Shaman7312/UV-Exposure/README.md

# UV-Exposure
Exposure unit for making PCBs
