Shaman7312/UV-Exposure/UV-Exposer_KiCad/UV-Exposer.kicad_pcb

## KiCad design UV-Exposer_KiCad/UV-Exposer.kicad_pcb (2017-09-11)

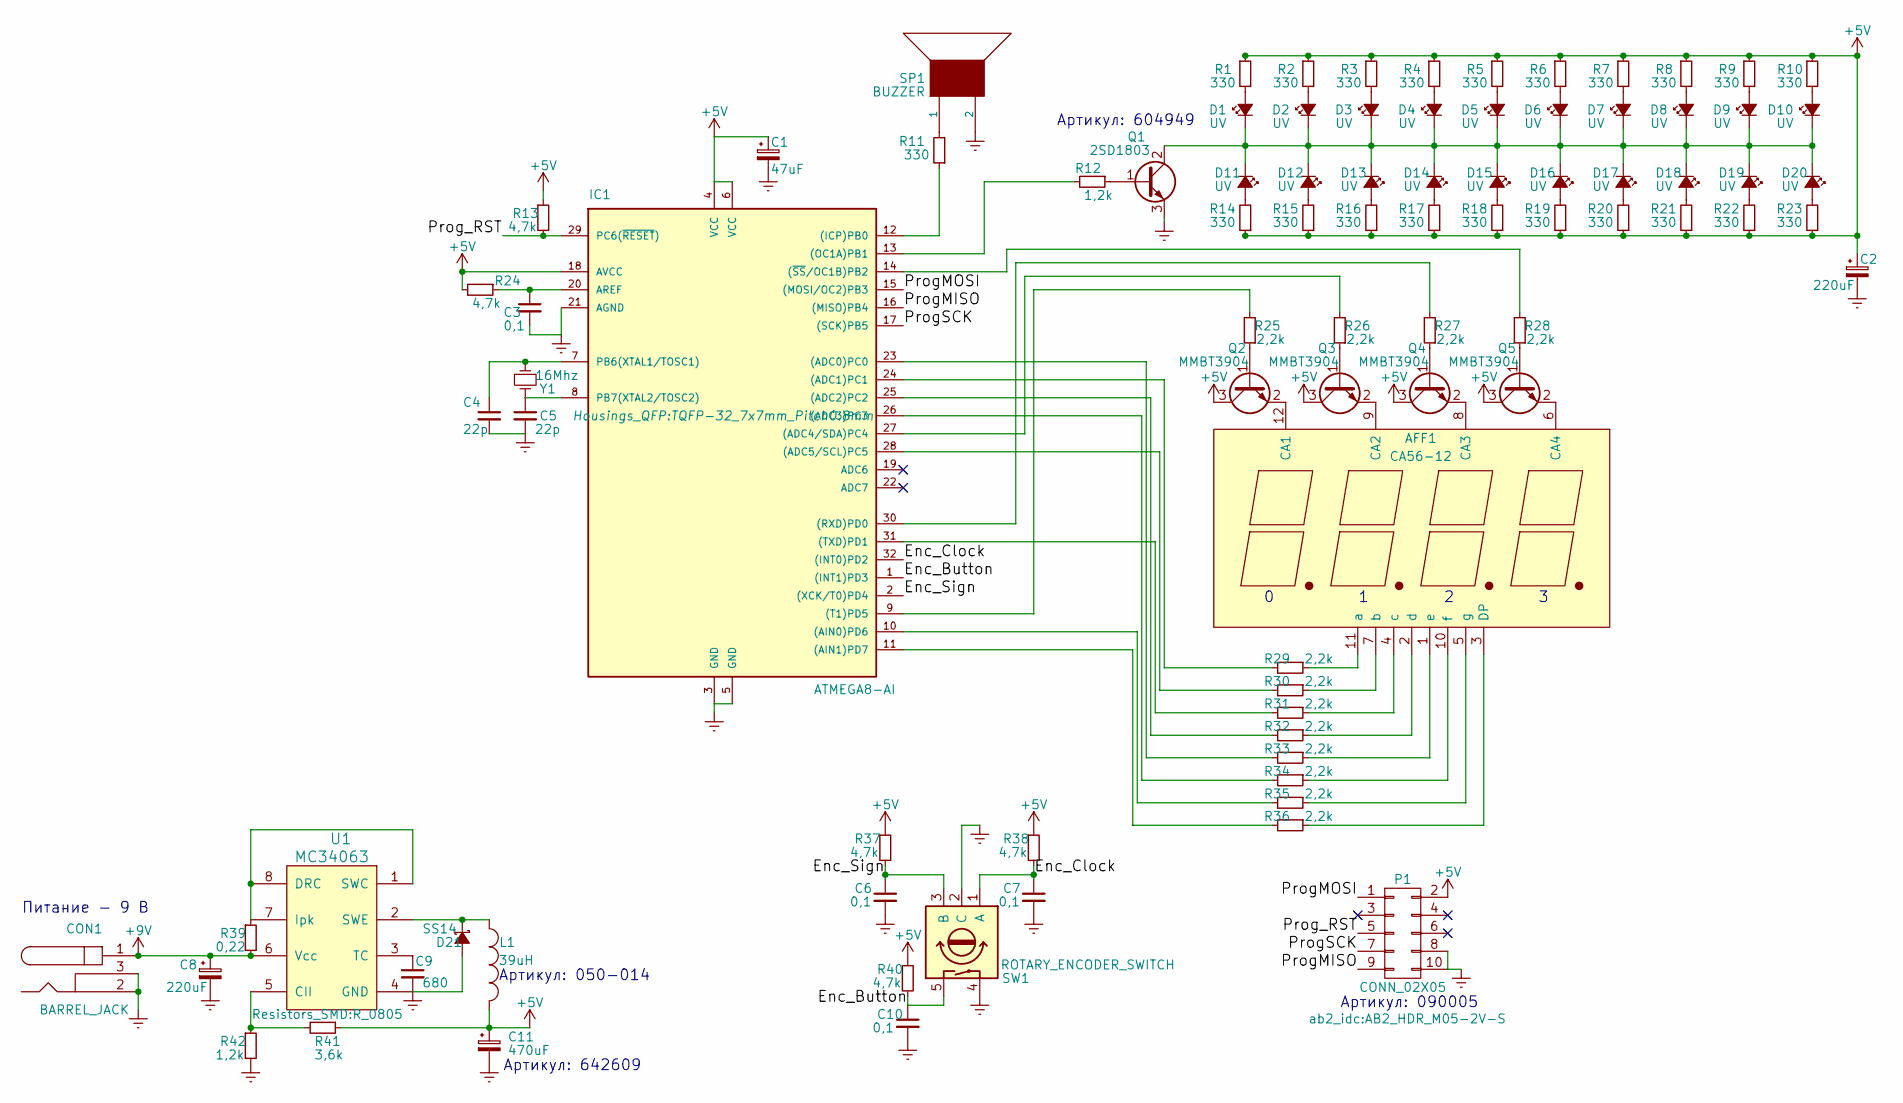
[picture p1: schematic UV-Exposer.sch]

Parts:
AFF1: CA56-12; CA56-12CGKWA
C1: 47uF; CP_Elec_5x5.3
C2, C8: 220uF; CP_Elec_6.3x5.3
C3, C6, C7, C10: 0,1; C_1206
C4, C5: 22p; C_1206
C9: 680; C_1206
C11: 470uF; CP_Elec_8x10
CON1: BARREL_JACK
D1, D2, D3, D4, D5, D6, D7, D8, D9, D10, D11, D12, D13, D14, D15, D16, D17, D18, D19, D20: UV; LED_D5.0mm
D21: SS14; D_SMA
IC1: ATMEGA8-AI; TQFP-32_7x7mm_Pitch0.8mm
L1: 39uH; Choke_SMD_12x12mm_h8mm
P1: CONN_02X05; AB2_HDR_M05-2V-S
Q1: 2SD1803; TO-252-2
Q2, Q3, Q4, Q5: MMBT3904; SOT-23
R1, R2, R3, R4, R5, R6, R7, R8, R9, R10, R11, R14, R15, R16, R17, R18, R19, R20, R21, R22, R23: 330; R_0805
R12: 1,2k; R_1206
R13, R24, R37, R38, R40: 4,7k; R_1206
R25, R26, R27, R28, R29, R30, R31, R32, R33, R34, R35, R36: 2,2k; R_1206
R39: 0,22; R_Axial_DIN0414_L11.9mm_D4.5mm_P15.24mm_Horizontal
R41: 3,6k; R_0805
R42: 1,2k; R_0805
SP1: BUZZER; MagneticBuzzer_ProSignal_ABI-009-RC
SW1: ROTARY_ENCODER_SWITCH; AB2_ROTARY_ENCODER_W_SWITCH
U1: MC34063; SOIC-8_3.9x4.9mm_Pitch1.27mm
Y1: 16Mhz; Crystal_HC49-U_Vertical

Connections:
+5V: C1.1, C2.1, C11.1, IC1.4 (VCC), IC1.6 (VCC), IC1.18 (AVCC), L1.2, P1.2, Q2.3 (C), Q3.3 (C), Q4.3 (C), Q5.3 (C), R1.1, R2.1, R3.1, R4.1, R5.1, R6.1, R7.1, R8.1, R9.1, R10.1, R13.1, R14.1, R15.1, R16.1, R17.1, R18.1, R19.1, R20.1, R21.1, R22.1, R23.1, R24.2, R37.1, R38.1, R40.1, R41.1
+9V: C8.1, CON1.1, R39.2, U1.6 (Vcc)
/Enc_Button: C10.1, IC1.1 ((INT1)PD3), R40.2, SW1.5
/Enc_Clock: C7.1, IC1.32 ((INT0)PD2), R38.2, SW1.1 (A)
/Enc_Sign: C6.1, IC1.2 ((XCK/T0)PD4), R37.2, SW1.3 (B)
/ProgMISO: IC1.16 ((MISO)PB4), P1.9
/ProgMOSI: IC1.15 ((MOSI/OC2)PB3), P1.1
/ProgSCK: IC1.17 ((SCK)PB5), P1.7
/Prog_RST: IC1.29 (PC6(~RESET~)), P1.5, R13.2
Earth: C1.2, C2.2, C3.2, C4.2, C5.2, C6.2, C7.2, C8.2, C9.2, C10.2, C11.2, CON1.2, CON1.3, D21.2 (A), IC1.3 (GND), IC1.5 (GND), IC1.21 (AGND), P1.8, P1.10, Q1.3 (E), R42.2, SP1.2, SW1.2 (C), SW1.4, U1.4 (GND)
unnamed: AFF1.1 (e), R33.1
unnamed: AFF1.2 (d), R32.1
unnamed: AFF1.3 (DP), R36.1
unnamed: AFF1.4 (c), R31.1
unnamed: AFF1.5 (g), R35.1
unnamed: AFF1.6 (CA4), Q5.2 (E)
unnamed: AFF1.7 (b), R30.1
unnamed: AFF1.8 (CA3), Q4.2 (E)
unnamed: AFF1.9 (CA2), Q3.2 (E)
unnamed: AFF1.10 (f), R34.1
unnamed: AFF1.11 (a), R29.1
unnamed: AFF1.12 (CA1), Q2.2 (E)
unnamed: C3.1, IC1.20 (AREF), R24.1
unnamed: C4.1, IC1.7 (PB6(XTAL1/TOSC1)), Y1.1
unnamed: C5.1, IC1.8 (PB7(XTAL2/TOSC2)), Y1.2
unnamed: C9.1, U1.3 (TC)
unnamed: D1.1 (K), D2.1 (K), D3.1 (K), D4.1 (K), D5.1 (K), D6.1 (K), D7.1 (K), D8.1 (K), D9.1 (K), D10.1 (K), D11.1 (K), D12.1 (K), D13.1 (K), D14.1 (K), D15.1 (K), D16.1 (K), D17.1 (K), D18.1 (K), D19.1 (K), D20.1 (K), Q1.2 (C)
unnamed: D1.2 (A), R1.2
unnamed: D2.2 (A), R2.2
unnamed: D3.2 (A), R3.2
unnamed: D4.2 (A), R4.2
unnamed: D5.2 (A), R5.2
unnamed: D6.2 (A), R6.2
unnamed: D7.2 (A), R7.2
unnamed: D8.2 (A), R8.2
unnamed: D9.2 (A), R9.2
unnamed: D10.2 (A), R10.2
unnamed: D11.2 (A), R14.2
unnamed: D12.2 (A), R15.2
unnamed: D13.2 (A), R16.2
unnamed: D14.2 (A), R17.2
unnamed: D15.2 (A), R18.2
unnamed: D16.2 (A), R19.2
unnamed: D17.2 (A), R20.2
unnamed: D18.2 (A), R21.2
unnamed: D19.2 (A), R22.2
unnamed: D20.2 (A), R23.2
unnamed: D21.1 (K), L1.1, U1.2 (SWE)
unnamed: IC1.9 ((T1)PD5), R25.2
unnamed: IC1.10 ((AIN0)PD6), R35.2
unnamed: IC1.11 ((AIN1)PD7), R36.2
unnamed: IC1.12 ((ICP)PB0), R11.1
unnamed: IC1.13 ((OC1A)PB1), R12.2
unnamed: IC1.14 ((~SS~/OC1B)PB2), R28.2
unnamed: IC1.23 ((ADC0)PC0), R33.2
unnamed: IC1.24 ((ADC1)PC1), R29.2
unnamed: IC1.25 ((ADC2)PC2), R32.2
unnamed: IC1.26 ((ADC3)PC3), R34.2
unnamed: IC1.27 ((ADC4/SDA)PC4), R26.2
unnamed: IC1.28 ((ADC5/SCL)PC5), R30.2
unnamed: IC1.30 ((RXD)PD0), R27.2
unnamed: IC1.31 ((TXD)PD1), R31.2
unnamed: Q1.1 (B), R12.1
unnamed: Q2.1 (B), R25.1
unnamed: Q3.1 (B), R26.1
unnamed: Q4.1 (B), R27.1
unnamed: Q5.1 (B), R28.1
unnamed: R11.2, SP1.1
unnamed: R39.1, U1.1 (SWC), U1.7 (Ipk), U1.8 (DRC)
unnamed: R41.2, R42.1, U1.5 (CII)

Notes on the sheet:
Питание - 9 В
Артикул: 050-014
Артикул: 604949
Артикул: 090005
Артикул: 642609

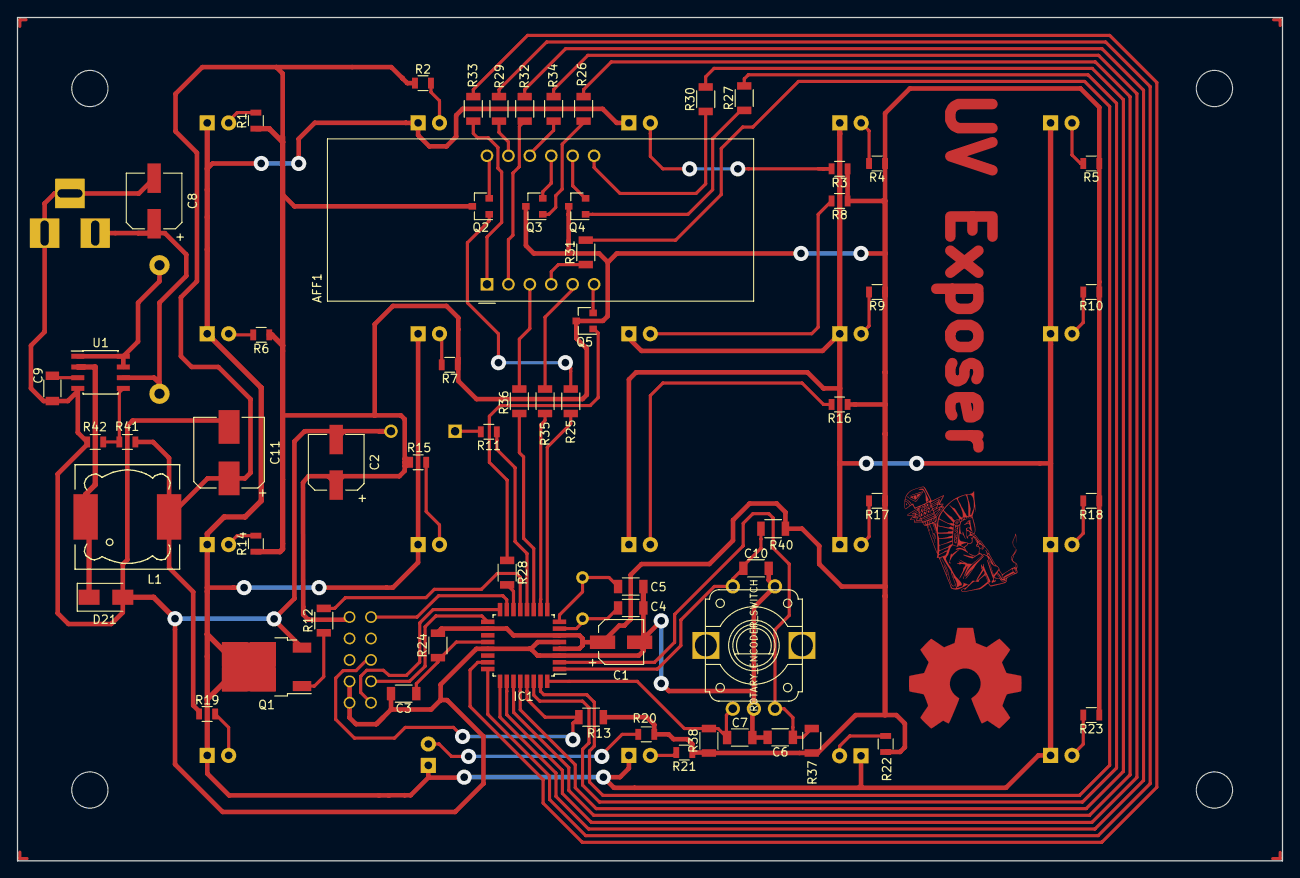
[picture p2: board UV-Exposer.kicad_pcb from above]

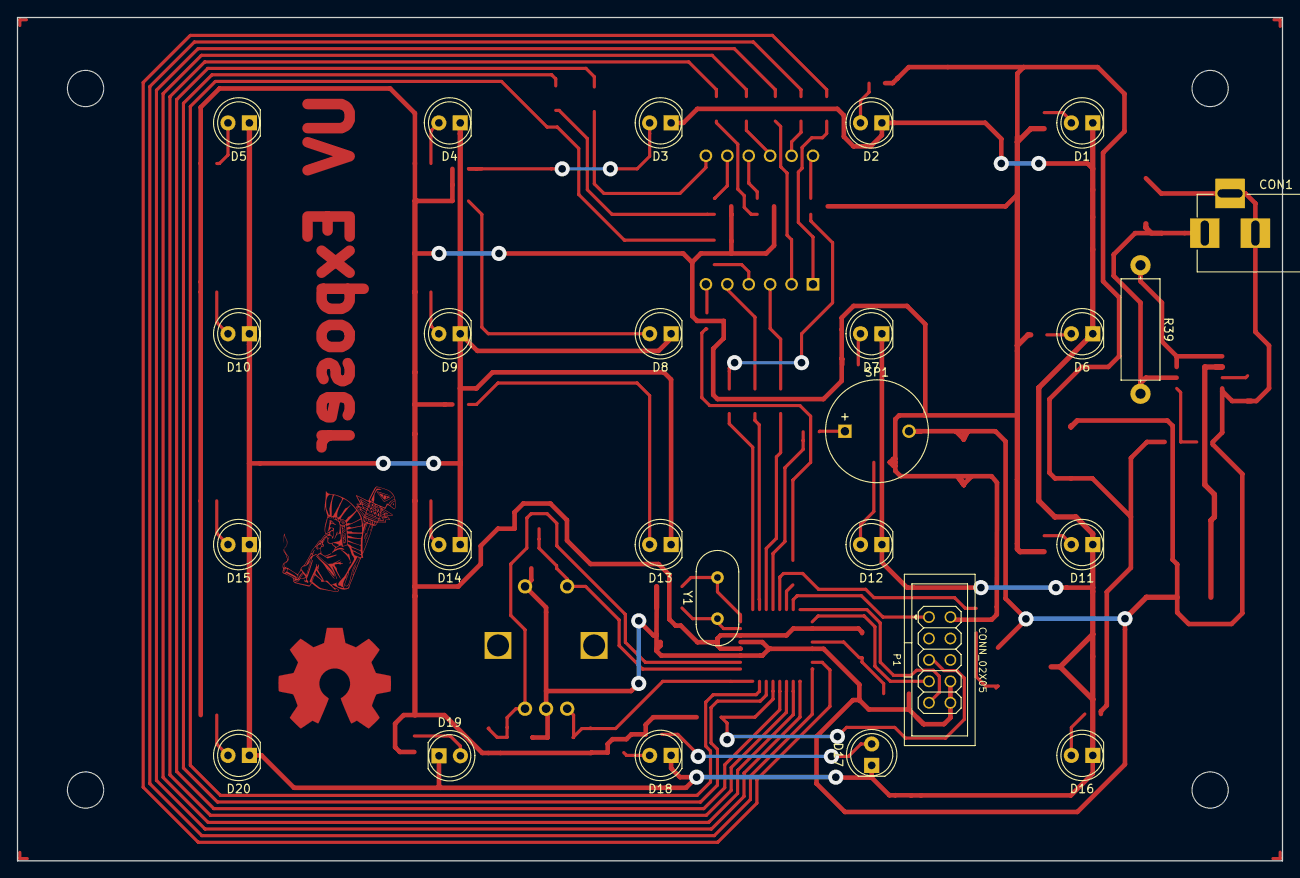
[picture p3: board UV-Exposer.kicad_pcb from below]

Board: 2 copper layers, 150.0 x 100.0 mm, 89 parts (25 on the bottom side), 70 nets.

Other parts of the board:
Shaman: Shaman_LOGO; shaman_logo13x13
